tslabs/neogs/z80/README

These are different Z80 tools, firmwares etc. used somewhere inside NGS...
