tslabs/neogs/pcad/README

P-CAD design files: .pcb, .sch and related
