tslabs/neogs/fpga/current/README

---------------------------------------
25.11.2010, lvd:

'реfuckторинг' кода - теперь главный код в current, удаляются старые файлы, переименовываются и т.д.
Заодно туда же будут добавляться новые фичи.

---------------------------------------
06.12.2009, lvd:

текущие исправления: добавлено инвертирование 7 бита семплов если включен х бит порта 0F.

---------------------------------------
--older--, lvd:

Всё, как в fpgaD (соответствует описанному в доке ngsprg_01a.pdf),
но ещё прибавлено ДМА через ZX-BUS

отлажен на модели дма-секвенсер

пишется дма для сдкарт
