tslabs/neogs/fpga/fpgaD_release/readme.txt

соответствует всему, что описано в ngsprm_01a.pdf
