tslabs/neogs/docs/История версий main_rom и загрузчика.odt

История версий основной прошивки NeoGS

08.08.2014 Версия 1.10

- внесено исправление команды 9xx.

18.06.2013 Версия 1.09 (1.06-1.08)

- ускорена конвертация загруженного модуля.

- частота процессора всегда 20 МГц вместо стандартных 12 МГц, выставляется загрузчиком.

- автоматическое определение количества памяти 2 или 4 мегабайта.

- еще что-то по мелочи.

История версий загрузчика.

18.06.2013 Версия 0.21

- исправлены недоработки FAT драйвера.

- добавлена возможность изменения частоты работы процессора и считывания текущей установленной частоты для работы основной прошивки.
