tslabs/neogs/docs/Формат заголовка прошивальщика.odt

Формат заголовка для прошивальщика v0.11

CRC16 вычисляется по алгоритму CRC16 CCITT. Порядок байт для длины и CRC16 сначала младший байт, потом старший.

При прошивании версии для NeoGS последние 8 байт в странице описателя блока прошиваются в адрес #FFF8 указанной страницы.

Формат даты (по битам):

15=0-бета версия, 1-стабильная

14-9=год сборки (последние 2 цифры)

8-5=месяц сборки

4-0=дата сборки

Смещение Длина Описание

---Заголовок---

0 2 Длина заголовка в байтах

2 4 Текст «NGSF» для NeoGS

6 2 Дата сборки этого файла

8 16 Описатель блока для прошивания (один или несколько)

24 16*N Еще описатели, если несколько

---Далее сами блоки для прошивания---

24+(16*N) N Сам блок

---16 байтный описатель блока---

0 1 Биты 7-3 — зарезервированы для возможного расширения

Биты 2-0 — номер страницы прошивания

2 3 Смещение в байтах от начала файла.

4 2 Размер для прошивания в байтах без CRC16.

6 2 CRC16 этого блока

8 8 Версия прошивки как задумана (6 байтов текста+2 байта даты)
