tslabs/neogs/pcad/revC/todo.txt

CHRV, 09.01.2011
+ PCB: сдвинул audio и SD разъемы к краю платы.

CHRV, 23.09.2010
+ PCB: разрешил земляные вопросы в разводке.

CHRV, 12.09.2010
+ SCH: исправил ошибки в наименовании элементов
+ SCH: добавил текст по логическим микросхемам
+ SCH: растащил немножко чертеж чтобы лучше печаталось
+ PCB: по просьбе резонита заменил дырки в слое board на mounting hole
+ VSD: сделал сборочный чертеж по PCB
+ PDF: сгенерил для печати монтажку и схему

CHRV, 31.08.2010
+ PCB: завершил разводить
+ LIB: увеличил контакты у OS7x5

CHRV, 03.06.2010
+ PCB: начал разводить

CHRV, 15.05.2010:
! LVD сделай совместимость страниц c NGS rev.B при условии что на rev.C будет 4мб.
? WARMRES пробуферировать на транзисторе (диоде) 
(чтобы не было замыкания выхода EPM3064 на гнд при нажатом сбросе на ZX)
+ SCH: сделал перенумерацию
+ SCH: заменил титульную надпись
+ SCH: сделал для ресета от спека развязку на диодах
+ SCH,LIB: добавил TDA1543T (в SO корпусе) как альтернатива DIP корпусу
+ LIB: добавил LL4148

LVD, 18.03.2010:

+ SCH: Перетащил жампер сброса со спека на /WARMRES

LVD, 16.03.2010: 
? - не сделанное, а пока дискусионное предложение.

? Перетащить сброс со спека на /WARMRES 
???

?  Из-за пуллапов на MEMA20,19,etc будут различия между страницами ОЗУ,
  
которые использует ЦПЛД для загрузки ФПГА. Надо подумать и пуллапами
  вернуть, 
как было.

? (не помню, обсуждалось ли уже) убрать ресет-тайм-конфигурацию ФПГА
  
(старые или новые чипы), но кодировать из 4х RAMCS'ов два и адрес.
  
При этот MEMA19, как задумывалось ещё давно, будет стоять над 4мя
  RAMCS'ами, 
чтобы со старыми чипами адресовалось 2 непрерывных метра,
  а с новыми - 4.

+ Добавил /WARMRES выход из 3064

CHRV, xx.xx.xxxx:

+ подтянул VER_C вывод (бывший RAMCS3) на GND (детект версии C платы)

+ использую выводы EPM3064ATC100 для конвертирования напряжения для ША и ШД памяти

+ добавил буфер 74LCX245 для конвертирования напряжения для ША памяти

+ добавил MEMA20 (бывший RAMCS2), MEMA19 

+ сделал память на TC55V8200FT (2x2MB)

+ заменил EPM3032ALC44 на EPM3064ATC100 

+ заменил SD карту на SDC09W4

+ заменил генераторы на OSC7x5

+ на схеме сделал нормальные порты для нетов (с указанием направлений)

+ заменил проц c Z84C0020VEC на Z84C0020FEC

+ L2 заменил на чип дроссель
