tslabs/neogs/pcad/revC/montage.pdf

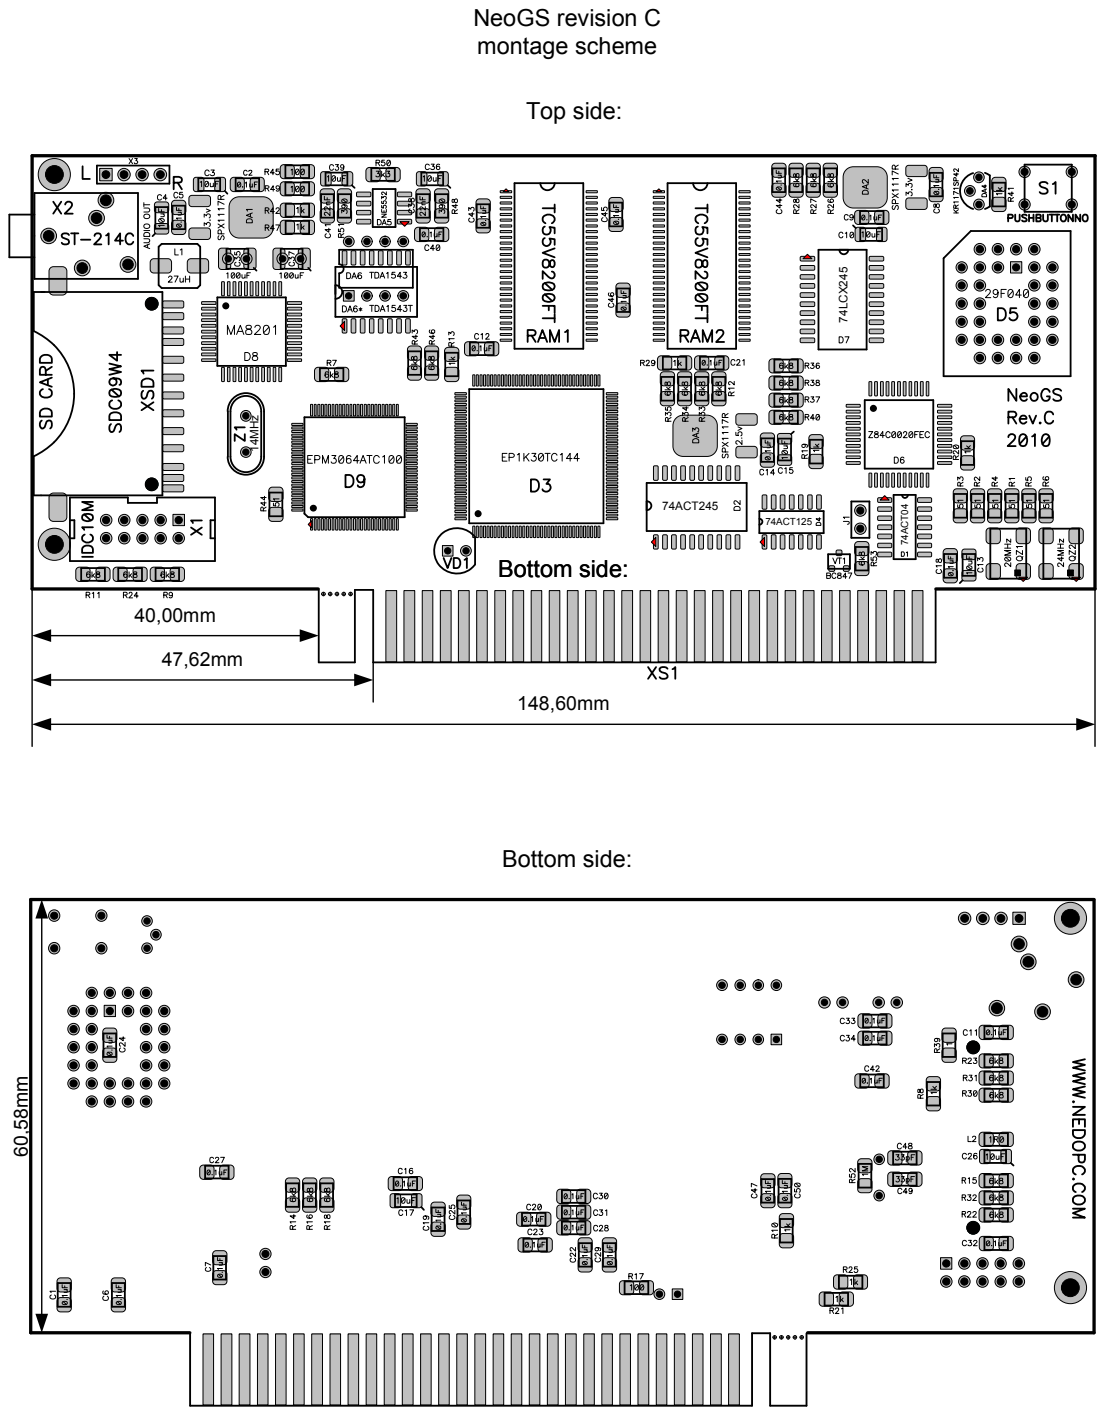
[picture p21: page 1]
14MHz; 74ACT245; 74ACT125; 74ACT04; 74LCX245; NeoGS revision C montage scheme; Top side:; Bottom side:
