tslabs/neogs/pcad/revC/scheme.pdf

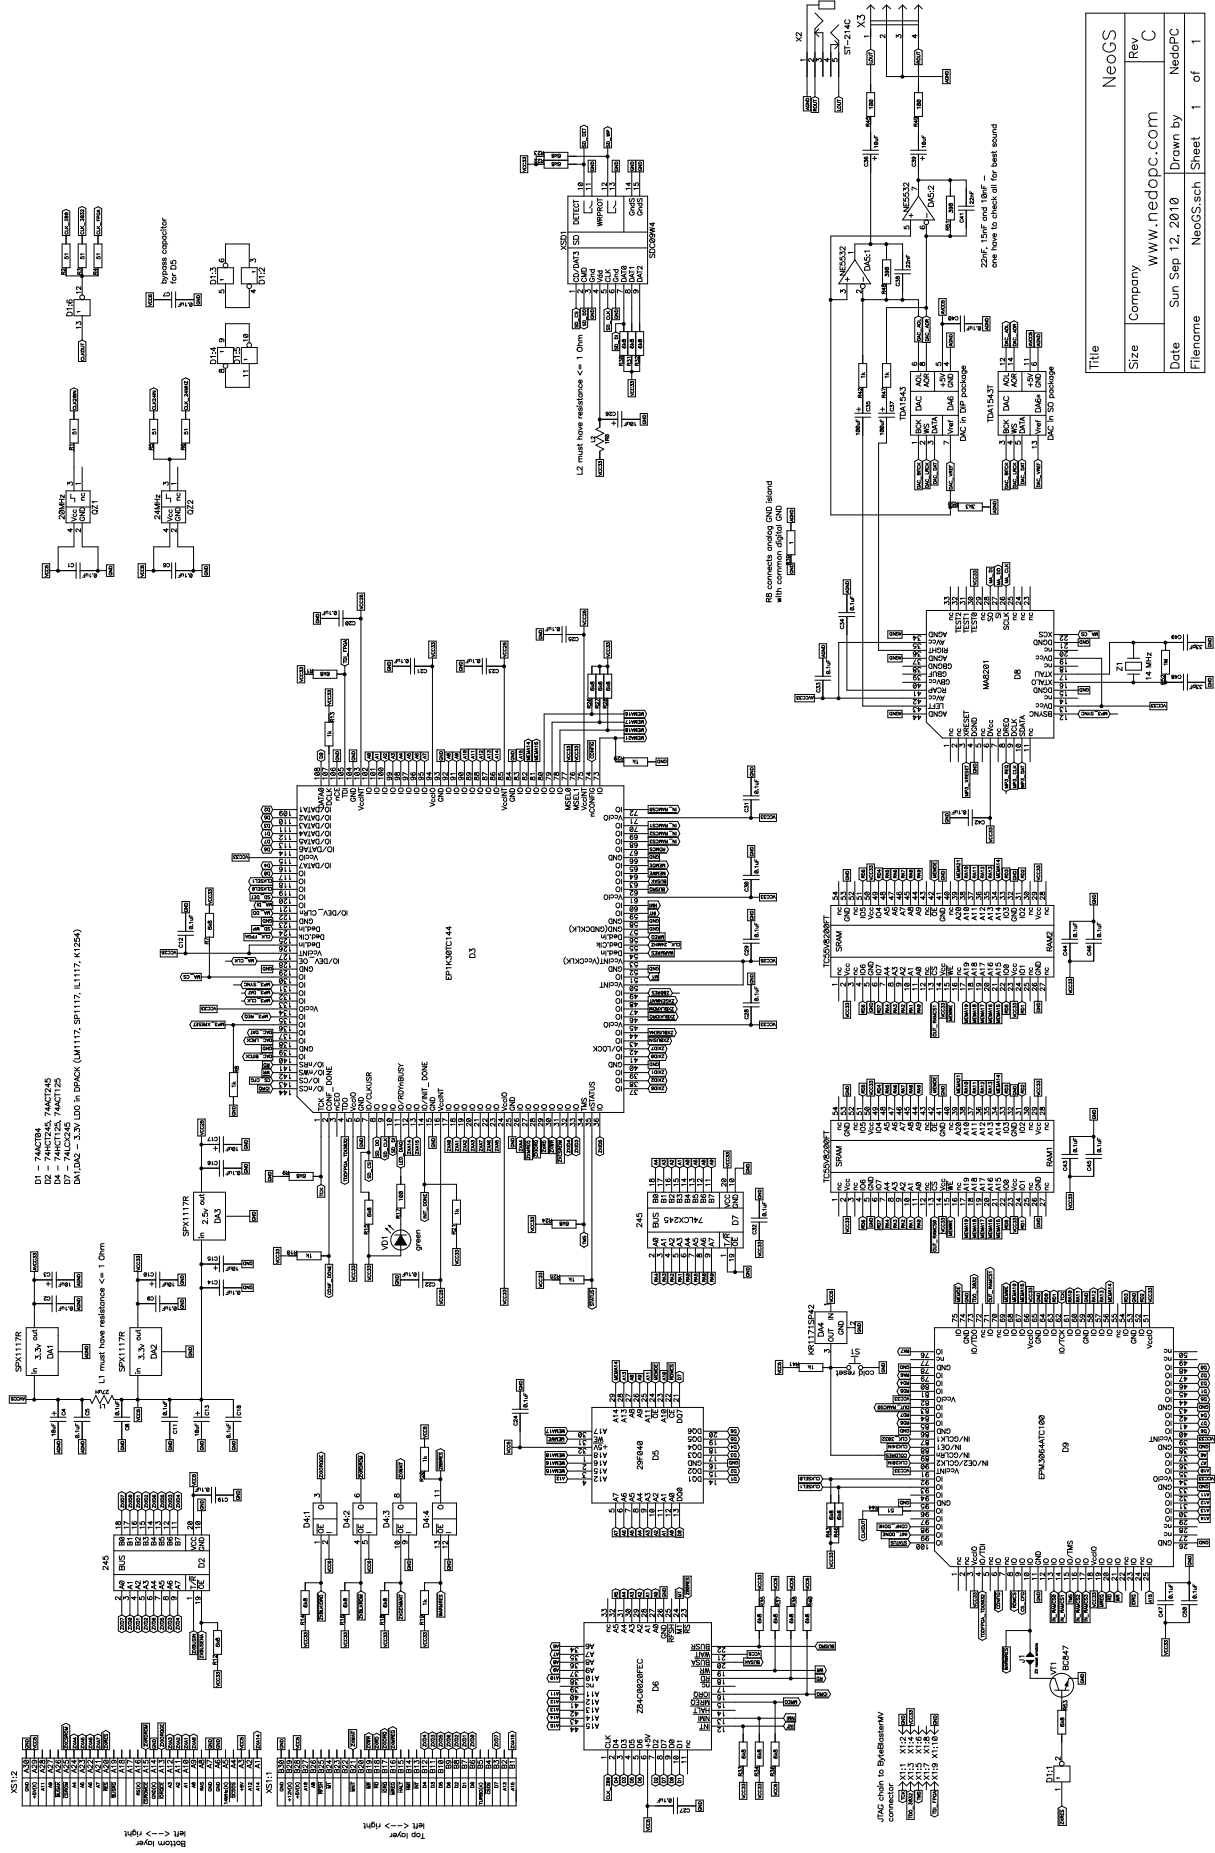
[picture p22: page 1]
