tslabs/neogs/(list of files, drawings)

Other design files:
pcad/revA/NewGS.pcb
pcad/revB/NewGS.pcb
pcad/revC/NeoGS.pcb
