tslabs/neogs/z80/main_rom/gsfrqtb.asm

GSFRQTB
;00
	DEFW h'4854,h'4446,h'4071,h'3CD1,h'3968,h'362F,h'3324,h'3045,h'2D91,h'2B02,h'2897,h'2652
	DEFW h'242A,h'2223,h'2037,h'1E68,h'1CB5,h'1B17,h'1992,h'1822,h'16C8,h'1581,h'144D,h'1329
	DEFW h'1215,h'1111,h'101B,h'0F35,h'0E5A,h'0D8D,h'0CCA,h'0C12,h'0B62,h'0AC0,h'0A26,h'0994
	DEFW h'090A,h'0888,h'080F,h'079A,h'072C,h'06C5,h'0663,h'0607,h'05B1,h'0560,h'0511,h'04C8
	DEFW h'0485,h'0444,h'0406,h'03CD,h'0397,h'0363,h'0333,h'0305,h'02DA,h'02AE,h'0288,h'0265
	DEFW h'0242,h'0222,h'0204,h'01E6,h'01CB,h'01B0,h'0198,h'0182,h'016D,h'0157,h'0144,h'0131
	DEFW h'0121,h'0111,h'0100,h'00F3,h'00E5,h'00D8,h'00CD,h'00BF,h'00B5,h'00AD,h'00A2,h'009A
	DEFW h'0092,h'0087,h'0081,h'0079,h'0071,h'006C,h'0066,h'0061,h'005B,h'0056,h'0051,h'004B
;01
	DEFW h'47D0,h'43C7,h'3FFA,h'3C62,h'38FE,h'35CB,h'32C6,h'2FEE,h'2D3D,h'2AB4,h'284E,h'260B
	DEFW h'23E6,h'21E5,h'1FFB,h'1E32,h'1C7F,h'1AE7,h'1964,h'17F7,h'169D,h'1558,h'1427,h'1305
	DEFW h'11F4,h'10F1,h'0FFD,h'0F18,h'0E3F,h'0D72,h'0CB2,h'0BFA,h'0B4F,h'0AAD,h'0A13,h'0981
	DEFW h'08FA,h'0878,h'07FE,h'078D,h'0721,h'06BA,h'0659,h'05FD,h'05A6,h'0555,h'0509,h'04C0
	DEFW h'047D,h'043C,h'0400,h'03C5,h'038F,h'035B,h'032B,h'02FF,h'02D4,h'02AC,h'0283,h'0260
	DEFW h'023D,h'021F,h'01FF,h'01E4,h'01C8,h'01AD,h'0195,h'017F,h'016A,h'0154,h'0141,h'0131
	DEFW h'011E,h'010E,h'0100,h'00F0,h'00E3,h'00D8,h'00CA,h'00BF,h'00B5,h'00AA,h'00A2,h'0097
	DEFW h'008F,h'0087,h'007F,h'0079,h'0071,h'006C,h'0066,h'005E,h'0059,h'0056,h'0051,h'004B
;02
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
	DEFW h'0A7A,h'0A7D,h'0A80,h'0A82,h'0A85,h'0A88,h'0A8B,h'0A8D
	DEFW h'0A90,h'0A93,h'0A95,h'0A98,h'0A9B,h'0A9E,h'0AA0,h'0AA3
	DEFW h'0AA6,h'0AA8,h'0AAB,h'0AAE,h'0AB0,h'0AB3,h'0AB6,h'0AB9
	DEFW h'0ABB,h'0ABE,h'0AC1,h'0AC3,h'0AC6,h'0AC9,h'0ACB,h'0ACE
