tslabs/neogs/z80/main_rom/sgen.asm

SGENTBE DEFW S0,S1,S2,S3,S4,S5,S6,S7,S8

SGENTBF DEFW SGEN1,SGEN2,SGEN3,SGEN4,SGEN5,SGEN6,SGEN7,SGEN8,SGEN9

        DUPL 12,0

SGEN	EXX
        INC D
        DEC D
        JP Z,SGEN_
        LD C,A
        LD A,D
        DEC A
        CP h'09
        JP NC,SGEN__
        ADD A,A
        ADD A, LOW (SGENTBF)
        LD L,A
        LD H, HIGH (SGENTBF)
        LD A, (HL)
        INC L
        LD H, (HL)
        LD L, A
        LD A, C
        JP (HL)

SGEN1   EXX
        ADD A, (HL)
        RRA
        LD (DE), A
        INC E
        EXX
        JP SGEN_

SGEN2   EXX
        SUB (HL)
        EXX
        LD H, HIGH (DIVTAB3)
        JP NC, SGEN2_2
        INC H
SGEN2_2 LD L, A
        LD A, (HL)
        EXX
        ADD A, (HL)
        LD (DE), A
        INC E
        ADD A, (HL)
        RRA
        LD (DE), A
        INC E
        EXX
        JP SGEN_

SGEN3   EXX
        ADD A,(HL)
        RRA
        EXX
        LD L,A
        ADD A,C
        RRA
        EXX
        LD (DE),A
        INC E
        EXX
        LD A,L
        EXX
        LD (DE),A
        INC E
        ADD A,(HL)
        RRA
        LD (DE),A
        INC E
        EXX
        JP SGEN_

SGEN4   EXX
        ADD A,(HL)
        RRA
        EXX
        LD L,A
        ADD A,C
        RRA
        EXX
        LD (DE),A
        INC E
        EXX
        LD A,L
        EXX
        LD (DE),A
        INC E
        LD (DE),A
        INC E
        ADD A,(HL)
        RRA
        LD (DE),A
        INC E
        EXX
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
        JP S_RET

S7      EXX
        PUSH BC
        EXX
        POP HL
        LD B,E
        LD E,H
        LD C,L
        CALL S7_
        JP S_RET

S8      EXX
        PUSH BC
        EXX
        POP HL
        LD B,E
        LD E,H
        LD C,L
        CALL S8_
        JP S_RET

;INCLUDE "SGEN1_L.asm"
S1      EXX
        SLA C
        JR C,S1_6
        LD A,IXL
        INC A
        JR Z,S1_2
        DEC A
        ADD A,E
        JR Z,S1_4
        JR C,S1_2
        BIT 7,C
        JR Z,S1_4
        LD IYL,A
        LD A,IXL
        SRL A
        SRL A
        ADD A,IYL
        JR Z,S1_4
        JR NC,S1_4
S1_2    DEFB h'CB,h'30;SLI B
        JR NC,S1_3
        LD A,E
        AND h'03
        JP Z,S11L0_1
        DEC A
        JP Z,S11L1_1
        DEC A
        JP Z,S11L2_1
        JP S11L3
S1_3    LD A,E
        AND h'03
        JP Z,S11H0_1
        DEC A
        JP Z,S11H1_1
        DEC A
        JP Z,S11H2_1
        JP S11H3
S1_4    DEFB h'CB,h'30;SLI B
        JR NC,S1_5
        LD A,E
        AND h'03
        JP Z,S12L0_1
        DEC A
        JP Z,S12L1_1
        DEC A
        JP Z,S12L2_1
        JP S12L3
S1_5    LD A,E
        AND h'03
        JP Z,S12H0_1
        DEC A
        JP Z,S12H1_1
        DEC A
        JP Z,S12H2_1
        JP S12H3

S1_6    LD A,IXL
        INC A
        JR Z,S1_7
        DEC A
        SRL A
        ADD A,IXL
        JR Z,S1_9
        JR C,S1_7
        ADD A,E
        JR C,S1_7
        BIT 7,C
        JR Z,S1_9
        LD IYL,A
        LD A,IXL
        SRL A
        SRL A
        ADD A,IYL
        JR Z,S1_9
        JR NC,S1_9
S1_7    DEFB h'CB,h'30;SLI B
        JR C,S1_8
        LD A,E
        AND h'03
        JP Z,S13L0
        DEC A
        JP Z,S13L1
        DEC A
        JP Z,S13L2
        JP S13L3
S1_8    LD A,E
        AND h'03
        JP Z,S13H0
        DEC A
        JP Z,S13H1
        DEC A
        JP Z,S13H2
        JP S13H3
S1_9    DEFB h'CB,h'30;SLI B
        JR C,S1_A
        LD A,E
        AND h'03
        JP Z,S14L0
        DEC A
        JP Z,S14L1
        DEC A
        JP Z,S14L2
        JP S14L3
S1_A    LD A,E
        AND h'03
        JP Z,S14H0
        DEC A
        JP Z,S14H1
        DEC A
        JP Z,S14H2
        JP S14H3

S11M0   LD B,A
        DEC HL
        LD A,(HL)
        INC HL
        ADD A,(HL)
        RRA
        LD (DE),A
        INC E
        LDI
        INC C
S11L2_1 LD A,B
S11L2_2 LDI
        INC C
        ADD A,C
        LD B,A
        JP NC,S11L3
        ADD A,C
        JP C,S11M3
S11G3   LD B,A
        DEC HL
        LD A,(HL)
        INC HL
        ADD A,(HL)
        RRA
        LD (DE),A
        INC E
        JR Z,S11R1
        LDI
        INC C
S11H1_1 LD A,B
S11H1_2 LDI
        INC C
        ADD A,C
        JP NC,S11H2_2
        LDI
        INC C
        ADD A,C
        LD B,A
        JP NC,S11L3
        ADD A,C
        JP C,S11M3
        JP S11G3

S11R1   LD IYL,A
        LD A,B
        SUB C
        LD B,A
        SRL B
        LD C,h'00
        LD A,IYL
        RET

S11M1   LD B,A
        DEC HL
        LD A,(HL)
        INC HL
        ADD A,(HL)
        RRA
        LD (DE),A
        INC E
        LDI
        INC C
S11L3   LD A,(HL)
        INC HL
        LD (DE),A
        INC E
        JR Z,S11R2
        LD A,B
        ADD A,C
        JP NC,S11L0_2
        ADD A,C
        JR C,S11M0
S11G0   LD B,A
        DEC HL
        LD A,(HL)
        INC HL
        ADD A,(HL)
        RRA
        LD (DE),A
        INC E
        LDI
        INC C
S11H2_1 LD A,B
S11H2_2 LDI
        INC C
        ADD A,C
        LD B,A
        JP NC,S11H3
        LD A,(HL)
        INC HL
        LD (DE),A
        INC E
        JR Z,S11R2
        LD A,B
        ADD A,C
        JP NC,S11L0_2
        ADD A,C
        JP C,S11M0
        JP S11G0

S11R2   LD IYL,A
        LD A,B
        ADD A,C
        LD B,A
        JR NC,S11R2_2
        LD C,h'01
        SRL B
        LD A,IYL
        RET
S11R2_2 LD C,h'00
        RRC B
        LD A,IYL
        RET

S11M2   LD B,A
        DEC HL
        LD A,(HL)
        INC HL
        ADD A,(HL)
        RRA
        LD (DE),A
        INC E
        LD A,(HL)
        INC HL
        LD (DE),A
        INC E
        JR Z,S11R3
S11L0_1 LD A,B
S11L0_2 LDI
        INC C
        ADD A,C
        JP NC,S11L1_2
        ADD A,C
        JR C,S11M1
S11G1   LD B,A
        DEC HL
        LD A,(HL)
        INC HL
        ADD A,(HL)
        RRA
        LD (DE),A
        INC E
        LDI
        INC C
S11H3   LD A,(HL)
        INC HL
        LD (DE),A
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
        INC HL
        LD (DE),A
        INC E
        JR Z,S14R5
        DEC IXL
        JR Z,S14R5
        JP NC,S14K0
        JP S14J0

S14R5   LD C,h'01
        JR NC,S14R5_2
        RRC B
        RET

S14R5_2 SRL B
        RET

S14R4   RRC B
        LD C,h'00
        RET

S14R1_3 JP S14R1

;INCLUDE "SGEN2_L.asm"
S2      LD H,HIGH (DIVTAB3)
        LD D,H
        INC D
        EXX
        SLA C
        JR C,S2_6
        LD A,IXL
        ADD A,A
        JR C,S2_2
        ADD A,E
        JR Z,S2_4
        JR C,S2_2
        BIT 7,C
        JR Z,S2_4
        LD IYL,A
        LD A,IXL
        SRL A
        SRL A
        ADD A,IYL
        JR Z,S2_4
        JR NC,S2_4
S2_2    DEFB h'CB,h'30;SLI B
        JR NC,S2_3
        LD A,E
        AND h'03
        JP Z,S21L0
        DEC A
        JP Z,S21L1
        DEC A
        JP Z,S21L2
        JP S21L3
S2_3    LD A,E
        AND h'03
        JP Z,S21H0
        DEC A
        JP Z,S21H1
        DEC A
        JP Z,S21H2
        JP S21H3
S2_4    DEFB h'CB,h'30;SLI B
        JR NC,S2_5
        LD A,E
        AND h'03
        JP Z,S22L0
        DEC A
        JP Z,S22L1
        DEC A
        JP Z,S22L2
        JP S22L3
S2_5    LD A,E
        AND h'03
        JP Z,S22H0
        DEC A
        JP Z,S22H1
        DEC A
        JP Z,S22H2
        JP S22H3

S2_6    LD A,IXL
        ADD A,A
        JR C,S2_7
        LD IYL,A
        LD A,IXL
        SRL A
        ADD A,IYL
        JR C,S2_7
        ADD A,E
        JR Z,S2_9
        JR C,S2_7
        BIT 7,C
        JR Z,S2_9
        LD IYL,A
        LD A,IXL
        SRL A
        SRL A
        ADD A,IYL
        JR Z,S2_9
        JR NC,S2_9
S2_7    DEFB h'CB,h'30;SLI B
        JR C,S2_8
        LD A,E
        AND h'03
        JP Z,S23L0
        DEC A
        JP Z,S23L1
        DEC A
        JP Z,S23L2
        JP S23L3
S2_8    LD A,E
        AND h'03
        JP Z,S23H0
        DEC A
        JP Z,S23H1
        DEC A
        JP Z,S23H2
        JP S23H3
S2_9    DEFB h'CB,h'30;SLI B
        JR C,S2_A
        LD A,E
        AND h'03
        JP Z,S24L0
        DEC A
        JP Z,S24L1
        DEC A
        JP Z,S24L2
        JP S24L3
S2_A    LD A,E
        AND h'03
        JP Z,S24H0
        DEC A
        JP Z,S24H1
        DEC A
        JP Z,S24H2
        JP S24H3

S21G0   LD E,A
        LD A,(DE)
        EXX
        ADD A,(HL)
        LD (DE),A
        INC E
S21J1   ADD A,(HL)
        RRA
        LD (DE),A
        INC E
S21H2   LD A,B
        ADD A,C
        LD B,A
        LD A,(HL)
        INC HL
        LD (DE),A
        INC E
        JP NC,S21J3
S21K3   ADD A,(HL)
        RRA
        LD (DE),A
        INC E
        JR Z,S21R1
S21L0   LD A,B
        ADD A,C
        LD B,A
        LD A,(HL)
        INC HL
        LD (DE),A
        INC E
        JP NC,S21K1
        SUB (HL)
        EXX
        JP C,S21G1
        LD L,A
        LD A,(HL)
        EXX
        ADD A,(HL)
        LD (DE),A
        INC E
        ADD A,(HL)
        RRA
        LD (DE),A
        INC E
        LD A,B
        ADD A,C
        LD B,A
        LD A,(HL)
        INC HL
        LD (DE),A
        INC E
        JR Z,S21R2
        JP C,S21K0
        JP S21J0

S21R1   LD C,h'00
        RRC B
        RET

S21R2   LD C,h'01
        JR NC,S21R2_2
        RRC B
        RET

S21R2_2 SRL B
        RET

S21G1   LD E,A
        LD A,(DE)
        EXX
        ADD A,(HL)
        LD (DE),A
        INC E
S21J2   ADD A,(HL)
        RRA
        LD (DE),A
        INC E
S21H3   LD A,B
        ADD A,C
        LD B,A
        LD A,(HL)
        INC HL
        LD (DE),A
        INC E
        JR Z,S21R2
        JP NC,S21J0
S21K0   ADD A,(HL)
        RRA
        LD (DE),A
        INC E
S21L1   LD A,B
        ADD A,C
        LD B,A
        LD A,(HL)
        INC HL
        LD (DE),A
        INC E
        JP NC,S21K2
        SUB (HL)
        EXX
        JP C,S21G2
        LD L,A
        LD A,(HL)
        EXX
        ADD A,(HL)
        LD (DE),A
        INC E
        ADD A,(HL)
        RRA
        LD (DE),A
        INC E
        JR Z,S21R3
        LD A,B
        ADD A,C
        LD B,A
        LD A,(HL)
        INC HL
        LD (DE),A
        INC E
        JP C,S21K1
        JP S21J1

S21R3   LD C,h'00
        SRL B
        RET

S21G2   LD E,A
        LD A,(DE)
        EXX
        ADD A,(HL)
        LD (DE),A
        INC E
S21J3   ADD A,(HL)
        RRA
        LD (DE),A
        INC E
        JR Z,S21R3
S21H0   LD A,B
        ADD A,C
        LD B,A
        LD A,(HL)
        INC HL
        LD (DE),A
        INC E
        JP NC,S21J1
S21K1   ADD A,(HL)
        RRA
        LD (DE),A
        INC E
S21L2   LD A,B
        ADD A,C
        LD B,A
        LD A,(HL)
        INC HL
        LD (DE),A
        INC E
        JP NC,S21K3
        SUB (HL)
        EXX
        JP C,S21G3
        LD L,A
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
        ADD A,(HL)
        LD (DE),A
        INC E
        ADD A,(HL)
        RRA
        LD (DE),A
        INC E
S24L3   LD A,B
        ADD A,C
        LD B,A
        LD A,(HL)
        INC HL
        LD (DE),A
        INC E
        JR Z,S24R4
        DEC IXL
        JR Z,S24R4
        JP C,S24K0

S24G0   ADD A,(HL)
        RRA
        LD (DE),A
        INC E
        LD A,B
        ADD A,C
        LD B,A
        LD A,(HL)
        INC HL
        LD (DE),A
        INC E
        DEC IXL
        JR Z,S24R2_3
        JP NC,S24K2
        JP S24J2

S24R4   JR C,S24R4_2
        LD C,h'01
        RRC B
        RET

S24R4_2 LD C,h'02
        SRL B
        RET

S24R2_3 JP S24R2

S24R5   LD C,h'01
        RRC B
        RET

S24J3   SUB (HL)
        EXX
        JP C,S24P3
        LD L,A
        LD A,(HL)
        EXX
        ADD A,(HL)
        LD (DE),A
        INC E
        JR Z,S24R5
        ADD A,(HL)
        RRA
        LD (DE),A
        INC E
        LD A,B
        ADD A,C
        LD B,A
        LD A,(HL)
        INC HL
        LD (DE),A
        INC E
        DEC IXL
        JR Z,S24R2_3
        JP C,S24J2
        JP S24K2

S24P3   LD E,A
        LD A,(DE)
        EXX
        ADD A,(HL)
        LD (DE),A
        INC E
        JR Z,S24R5
        ADD A,(HL)
        RRA
        LD (DE),A
        INC E
S24H1   LD A,B
        ADD A,C
        LD B,A
        LD A,(HL)
        INC HL
        LD (DE),A
        INC E
        DEC IXL
        JR Z,S24R2_3
        JP C,S24J2
S24K2   SUB (HL)
        EXX
        JP C,S24I2
        LD L,A
        LD A,(HL)
        EXX
        ADD A,(HL)
        LD (DE),A
        INC E
        ADD A,(HL)
        RRA
        LD (DE),A
        INC E
        JR Z,S24R6
        LD A,B
        ADD A,C
        LD B,A
        LD A,(HL)
        INC HL
        LD (DE),A
        INC E
        DEC IXL
        JR Z,S24R4
        JP C,S24K1
        JP S24G1

S24I2   LD E,A
        LD A,(DE)
        EXX
        ADD A,(HL)
        LD (DE),A
        INC E
        ADD A,(HL)
        RRA
        LD (DE),A
        INC E
        JR Z,S24R6
S24L0   LD A,B
        ADD A,C
        LD B,A
        LD A,(HL)
        INC HL
        LD (DE),A
        INC E
        DEC IXL
        JR Z,S24R4_4
        JP C,S24K1
S24G1   ADD A,(HL)
        RRA
        LD (DE),A
        INC E
        LD A,B
        ADD A,C
        LD B,A
        LD A,(HL)
        INC HL
        LD (DE),A
        INC E
        DEC IXL
        JR Z,S24R2_4
        JP NC,S24K3
        JP S24J3

S24R2_4 JP S24R2

S24R4_4 JP S24R4

S24R6   LD C,h'00
        SRL B
        RET

;INCLUDE "SGEN3.asm"
S3_     LD D,C
        PUSH DE
        LD D,B
        EXX
        POP BC
S31     SLA B
        JP C,S318

S310    LD A,IXL
        ADD A,A
        JP C,S311
        ADD A,IXL
        JP C,S311
        ADD A,E
        JR Z,S310_
        JP C,S311
        BIT 7,B
        JR Z,S310_
        LD IYL,A
        LD A,IXL
        SRL A
        SRL A
        ADD A,IYL
        JR Z,S310_
        JP C,S311
S310_   DEFB h'CB,h'31;SLI C
        JP C,S3101
        JP S3100

S3102   JR Z,S3104
S310A   INC E
        JR Z,S3105
        ADD A,(HL)
        RRA
        LD (DE),A
        INC E
        JR Z,S31052
        LD (DE),A
        INC E
        JR Z,S31053
S3100   LD A,C
        ADD A,B
        LD C,A
        LD A,(HL)
        INC HL
        DEC IXL
        LD (DE),A
        JP NC,S3102
        JR Z,S3106
        INC E
        JR Z,S3107
        LD IYL,A
        ADD A,(HL)
        RRA
        LD IYH,A
        ADD A,IYL
        RRA
        LD (DE),A
        INC E
        JR Z,S3109
        LD A,IYH
        LD (DE),A
        INC E
        JR Z,S31092
        ADD A,(HL)
        RRA
        LD (DE),A
        INC E
        JP NZ,S3101
        JP S31093

S3103   JR Z,S3108
        INC E
        JR Z,S3109
        ADD A,(HL)
        RRA
        LD (DE),A
        INC E
        JR Z,S31092
        LD (DE),A
        INC E
        JR Z,S31093
S3101   LD A,C
        ADD A,B
        LD C,A
        LD A,(HL)
        INC HL
        DEC IXL
        LD (DE),A
        JP NC,S3103
        JP NZ,S310A
S3104   INC E
S3105   SRL C
        LD IYL,C
        EXX
        LD E,IYL
        LD D,2
        RET

S31052  SRL C
        LD IYL,C
        EXX
        LD E,IYL
        LD D,1
        RET

S31053  SRL C
        LD IYL,C
        EXX
        LD E,IYL
        LD D,0
        RET

S3106   INC E
S3107   RRC C
        LD IYL,C
        EXX
        LD E,IYL
        RET

S3108   INC E
S3109   RRC C
        LD IYL,C
        EXX
        LD E,IYL
        DEC D
        RET

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
        INC E
        JP NZ,S818222
        RRC C
        LD IYL,C
        EXX
        LD E,IYL
        RET

S81844  INC E
        RRC C
        LD IYL,C
        EXX
        LD E,IYL
        RET

S8187   INC E
S8188   SRL C
        LD IYL,C
        EXX
        LD E,IYL
        RET

S8189   SRL C
        LD IYL,C
        EXX
        LD E,IYL
        LD D,7
        RET

S81871  INC E
S81891  SRL C
        LD IYL,C
        EXX
        LD E,IYL
        LD D,6
        RET

S81892  SRL C
        LD IYL,C
        EXX
        LD E,IYL
        LD D,5
        RET

S81893  SRL C
        LD IYL,C
        EXX
        LD E,IYL
        LD D,4
        RET

S81894  SRL C
        LD IYL,C
        EXX
        LD E,IYL
        LD D,3
        RET

S81895  SRL C
        LD IYL,C
        EXX
        LD E,IYL
        LD D,2
        RET

S81896  SRL C
        LD IYL,C
        EXX
        LD E,IYL
        LD D,1
        RET

S81897  SRL C
        LD IYL,C
        EXX
        LD E,IYL
        LD D,0
        RET
