tslabs/neogs/z80/main_rom/comtab.asm

COMTAB	DEFW COM00,COM01,COM02,COM03,COM04,COM05,COM06,COM07	;0365,036C,0381,0390,039E,03A8,03B8,03D0
		DEFW COM08,COM09,COM0A,COM0B,COM0C,COM0D,COM0E,COM0F	;0360,03F3,0407,041F,0444,046E,0497,04AE
		DEFW COM10,COM11,COM12,COM13,COM14,COM15,COM16,COM17	;0511,0522,052E,0537,0545,0594,05FE,0617
		DEFW COM18,COM19,COM1A,COM1B,COM1C,COM1D,COM1E,COM1F	;062A,063A,0642,064A,0650,0662,0360,0360
		DEFW COMF0,COMF1,COMF2,COMF3,COMF4,COMF5,COMF6,COMF7	;066F,0360,0360,0679,067E,0683,069B,06B0
		DEFW COMF8,COMF9,COMFA,COMFB,COMFC,COMFD,COMFE,COMFF	;0360,0360,06B9,0360,0360,0360,0360,0360
