tslabs/neogs/z80/main_rom/divtab3.asm

DIVTAB3
	DEFB h'00,h'01,h'01,h'02,h'03,h'03,h'04,h'05,h'05,h'06,h'07,h'07,h'08,h'09,h'09,h'0A
	DEFB h'0B,h'0B,h'0C,h'0D,h'0D,h'0E,h'0F,h'0F,h'10,h'11,h'11,h'12,h'13,h'13,h'14,h'15
	DEFB h'15,h'16,h'17,h'17,h'18,h'19,h'19,h'1A,h'1B,h'1B,h'1C,h'1D,h'1D,h'1E,h'1F,h'1F
	DEFB h'20,h'21,h'21,h'22,h'23,h'23,h'24,h'25,h'25,h'26,h'27,h'27,h'28,h'29,h'29,h'2A
	DEFB h'2B,h'2B,h'2C,h'2D,h'2D,h'2E,h'2F,h'2F,h'30,h'31,h'31,h'32,h'33,h'33,h'34,h'35
	DEFB h'35,h'36,h'37,h'37,h'38,h'39,h'39,h'3A,h'3B,h'3B,h'3C,h'3D,h'3D,h'3E,h'3F,h'3F
	DEFB h'40,h'41,h'41,h'42,h'43,h'43,h'44,h'45,h'45,h'46,h'47,h'47,h'48,h'49,h'49,h'4A
	DEFB h'4B,h'4B,h'4C,h'4D,h'4D,h'4E,h'4F,h'4F,h'50,h'51,h'51,h'52,h'53,h'53,h'54,h'55
	DEFB h'55,h'56,h'57,h'57,h'58,h'59,h'59,h'5A,h'5B,h'5B,h'5C,h'5D,h'5D,h'5E,h'5F,h'5F
	DEFB h'60,h'61,h'61,h'62,h'63,h'63,h'64,h'65,h'65,h'66,h'67,h'67,h'68,h'69,h'69,h'6A
	DEFB h'6B,h'6B,h'6C,h'6D,h'6D,h'6E,h'6F,h'6F,h'70,h'71,h'71,h'72,h'73,h'73,h'74,h'75
	DEFB h'75,h'76,h'77,h'77,h'78,h'79,h'79,h'7A,h'7B,h'7B,h'7C,h'7D,h'7D,h'7E,h'7F,h'7F
	DEFB h'80,h'81,h'81,h'82,h'83,h'83,h'84,h'85,h'85,h'86,h'87,h'87,h'88,h'89,h'89,h'8A
	DEFB h'8B,h'8B,h'8C,h'8D,h'8D,h'8E,h'8F,h'8F,h'90,h'91,h'91,h'92,h'93,h'93,h'94,h'95
	DEFB h'95,h'96,h'97,h'97,h'98,h'99,h'99,h'9A,h'9B,h'9B,h'9C,h'9D,h'9D,h'9E,h'9F,h'9F
	DEFB h'A0,h'A1,h'A1,h'A2,h'A3,h'A3,h'A4,h'A5,h'A5,h'A6,h'A7,h'A7,h'A8,h'A9,h'A9,h'AA
	DEFB h'55,h'56,h'57,h'57,h'58,h'59,h'59,h'5A,h'5B,h'5B,h'5C,h'5D,h'5D,h'5E,h'5F,h'5F
	DEFB h'60,h'61,h'61,h'62,h'63,h'63,h'64,h'65,h'65,h'66,h'67,h'67,h'68,h'69,h'69,h'6A
	DEFB h'6B,h'6B,h'6C,h'6D,h'6D,h'6E,h'6F,h'6F,h'70,h'71,h'71,h'72,h'73,h'73,h'74,h'75
	DEFB h'75,h'76,h'77,h'77,h'78,h'79,h'79,h'7A,h'7B,h'7B,h'7C,h'7D,h'7D,h'7E,h'7F,h'7F
	DEFB h'80,h'81,h'81,h'82,h'83,h'83,h'84,h'85,h'85,h'86,h'87,h'87,h'88,h'89,h'89,h'8A
	DEFB h'8B,h'8B,h'8C,h'8D,h'8D,h'8E,h'8F,h'8F,h'90,h'91,h'91,h'92,h'93,h'93,h'94,h'95
	DEFB h'95,h'96,h'97,h'97,h'98,h'99,h'99,h'9A,h'9B,h'9B,h'9C,h'9D,h'9D,h'9E,h'9F,h'9F
	DEFB h'A0,h'A1,h'A1,h'A2,h'A3,h'A3,h'A4,h'A5,h'A5,h'A6,h'A7,h'A7,h'A8,h'A9,h'A9,h'AA
	DEFB h'AB,h'AB,h'AC,h'AD,h'AD,h'AE,h'AF,h'AF,h'B0,h'B1,h'B1,h'B2,h'B3,h'B3,h'B4,h'B5
	DEFB h'B5,h'B6,h'B7,h'B7,h'B8,h'B9,h'B9,h'BA,h'BB,h'BB,h'BC,h'BD,h'BD,h'BE,h'BF,h'BF
	DEFB h'C0,h'C1,h'C1,h'C2,h'C3,h'C3,h'C4,h'C5,h'C5,h'C6,h'C7,h'C7,h'C8,h'C9,h'C9,h'CA
	DEFB h'CB,h'CB,h'CC,h'CD,h'CD,h'CE,h'CF,h'CF,h'D0,h'D1,h'D1,h'D2,h'D3,h'D3,h'D4,h'D5
	DEFB h'D5,h'D6,h'D7,h'D7,h'D8,h'D9,h'D9,h'DA,h'DB,h'DB,h'DC,h'DD,h'DD,h'DE,h'DF,h'DF
	DEFB h'E0,h'E1,h'E1,h'E2,h'E3,h'E3,h'E4,h'E5,h'E5,h'E6,h'E7,h'E7,h'E8,h'E9,h'E9,h'EA
	DEFB h'EB,h'EB,h'EC,h'ED,h'ED,h'EE,h'EF,h'EF,h'F0,h'F1,h'F1,h'F2,h'F3,h'F3,h'F4,h'F5
	DEFB h'F5,h'F6,h'F7,h'F7,h'F8,h'F9,h'F9,h'FA,h'FB,h'FB,h'FC,h'FD,h'FD,h'FE,h'FF,h'FF

___LEND
