tslabs/neogs/(commit log)

2012-03-14 Initial commit (from NedoPC's rev83)
    [NeoGS.pcb, NeoGS.sch, NewGS.pcb, NewGS.sch]
2012-10-09 ROM: fixed obsolete memory abusing while samples conversion, changed version to 1.08, added 512kB image assembling
    [main_ngs.asm]
2012-10-09 ROM: fix to droch-fix =)
    [main_ngs.asm]
2012-10-09 ROM: fixed obsolete memory abusing while samples conversion-2
    [main_ngs.asm]
2014-08-07 ROM: added psb's patch for 9xx command - if offset is larger than sample it now jumps to the LOOP point
